paso42/HM-Bell/images/HM-Bell_v2_bottomlayer.jpg

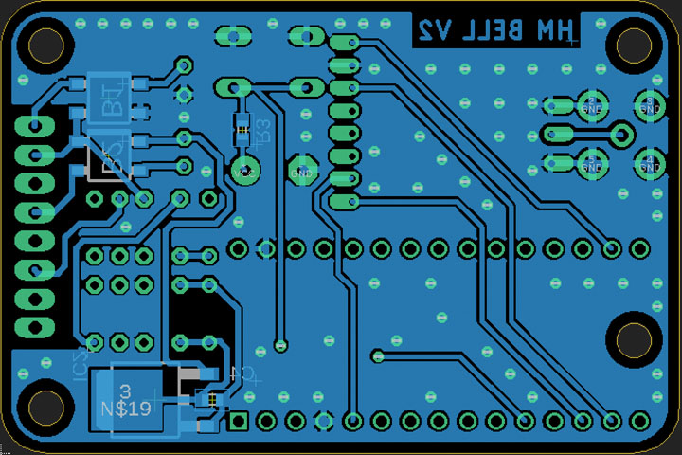
images/HM-Bell_v2_bottomlayer.jpg
