paso42/HM-Bell/images/HM-Bell_v2_shematic.jpg

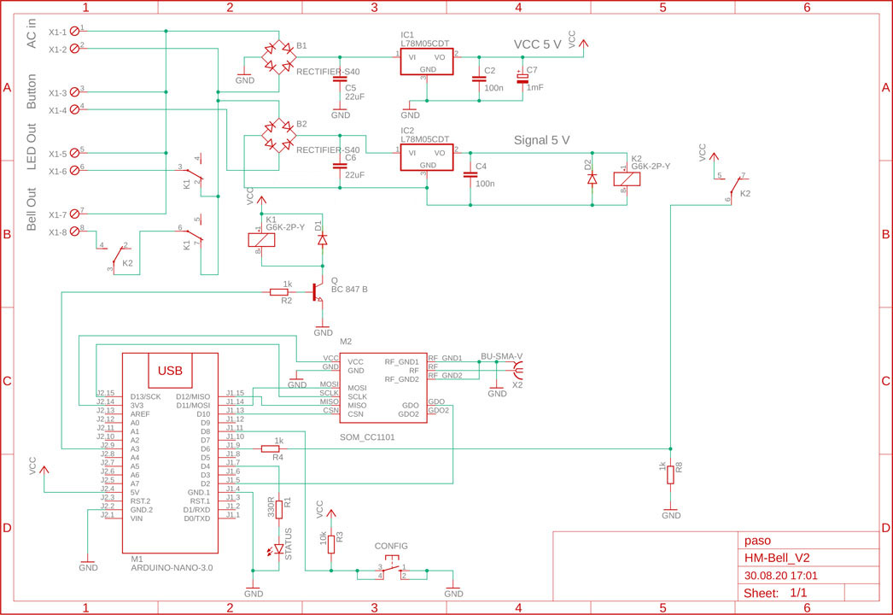
images/HM-Bell_v2_shematic.jpg
