paso42/HM-Bell/images/HM-Bell_v2_toplayer.jpg

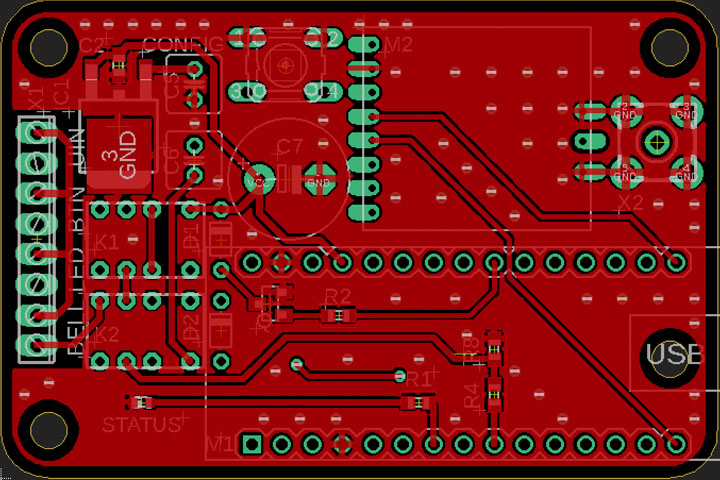
images/HM-Bell_v2_toplayer.jpg
