paso42/HM-Bell/images/HM-Bell_v2_view_top.jpg

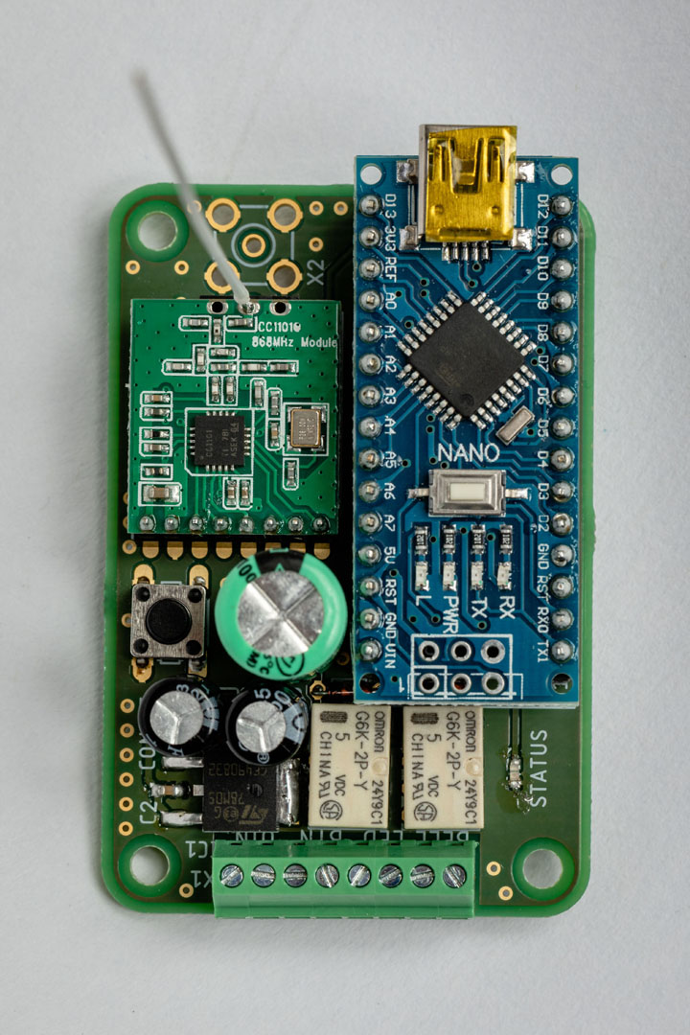
images/HM-Bell_v2_view_top.jpg
