paso42/HM-Bell/images/Screenshot_WebUI_Locked_Button.png

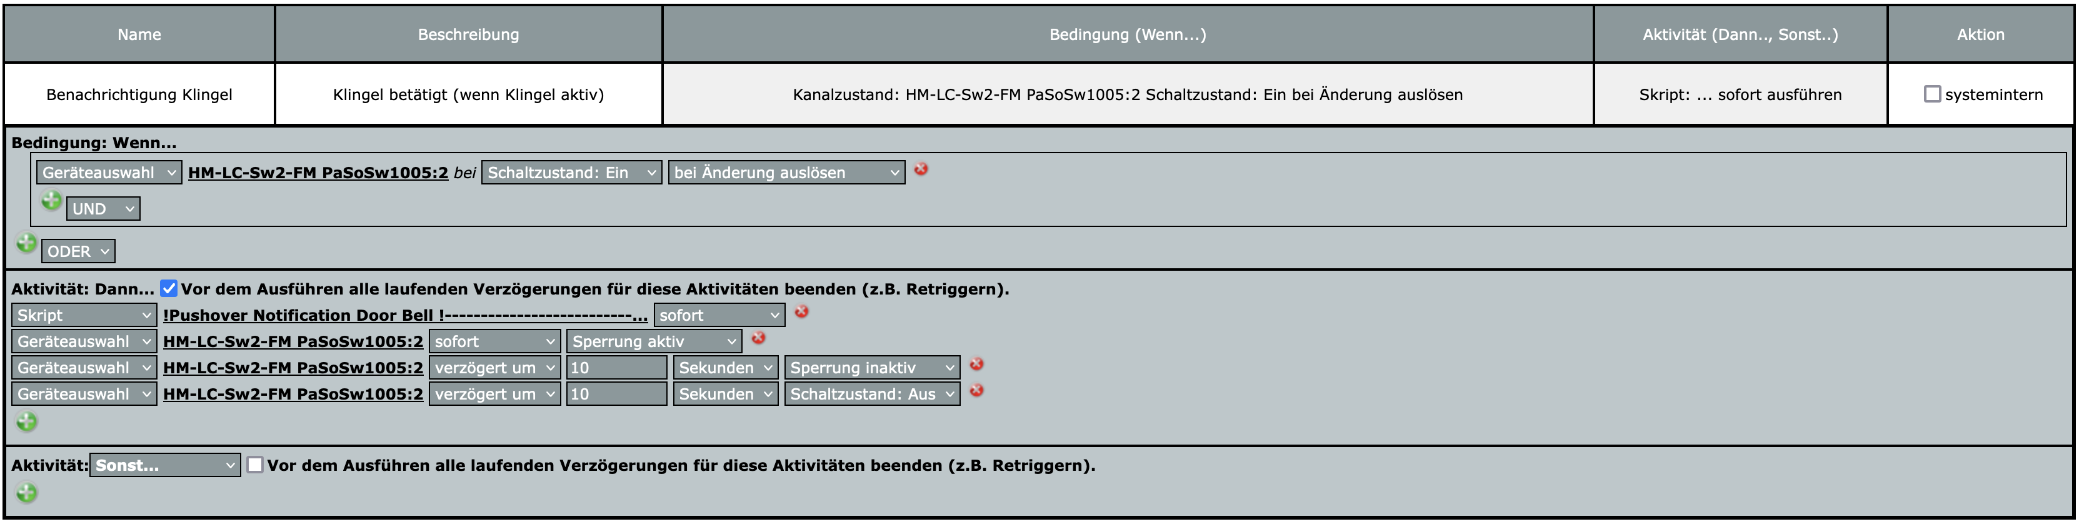
images/Screenshot_WebUI_Locked_Button.png
